enzogrando/GloveBot/docs/GloveBot_URD_.docx

PROJETO: GloveBot

Documento de Requisitos de Usuário (URD)

Luva de Controle de Garra Robótica via Bluetooth

Versão | V.2.0.0 | Data | 05/2026
Disciplina | Microcontroladores e Sistemas Embarcados | Prof. | Sérgio
Equipe | Enzo Medeiros Grando, Pedro Kuba Bloise, Gustavo Henrique Lamberti Widosnck, Gabriel Coutinho, João Victor Pessoa de Lima dos Anjos

# 1. Conceito e Descrição do Projeto

O GloveBot é um sistema embarcado de teleoperação robótica vestível que permite ao usuário controlar uma garra mecânica por meio de gestos naturais da mão. O sistema é composto por dois módulos: um emissor integrado a uma luva (wearable) e um receptor acoplado à garra robótica.

O módulo emissor, baseado na placa LilyPad IOT ATMega32U4, utiliza o acelerômetro MPU-6050 para capturar a inclinação e os movimentos do pulso do usuário, transmitindo esses dados sem fio via Bluetooth (HC-08 em modo Master) ao módulo receptor. O receptor, controlado pelo mbed LPC1768 (Cortex-M3), interpreta os dados recebidos via HC-08 em modo Slave e aciona o servo motor MG995 para abrir ou fechar a garra metálica de forma proporcional ao gesto detectado. O status da operação, incluindo o ângulo atual e a situação da garra (FECHADO, MEIO ou ABERTO), é exibido em tempo real em um display OLED 128x32 via I2C.

O projeto tem aplicação em robótica industrial e teleoperada, sendo especialmente relevante em cenários onde o operador humano precisa manipular objetos à distância — como em ambientes insalubres, perigosos ou de difícil acesso físico. Toda a solução é construída com módulos comerciais de baixo custo e fácil reposição, com o código-fonte, esquemático e documentação disponibilizados em repositório público no GitHub.

# 2. Diagrama de Blocos do Sistema

O sistema é composto por dois subsistemas que se comunicam via Bluetooth BLE — o emissor (luva) e o receptor (garra):

MÓDULO EMISSOR — LUVA

Acelerômetro (MPU-6050) | Microcontrolador (LilyPad ATMega32U4) | Bluetooth Master (HC-08)
Bateria Li-Ion Wearable | | Luva de Neoprene

↓ Bluetooth 4.0 BLE ↓

MÓDULO RECEPTOR — GARRA

Bluetooth Slave (HC-08) | Microcontrolador (mbed LPC1768) | Servo Motor (MG995)
Display OLED 128x32 | | Fonte 5V - 2A Externa

O MPU-6050 envia dados de aceleração ao LilyPad via I2C. O LilyPad calcula o pitch (ângulo de inclinação) e mapeia em um ângulo de 0° a 180°, transmitindo via Bluetooth para o mbed. O mbed converte o valor em sinal PWM para o servo MG995 e atualiza o display OLED em tempo real.

# 3. Componentes do Sistema

Módulo | Componente | Função
Luva (Emissor) | LilyPad IOT ATMega32U4 | Microcontrolador principal vestível
Luva (Emissor) | Acelerômetro MPU-6050 | Captura de movimento e inclinação do pulso (I2C)
Luva (Emissor) | Módulo Bluetooth HC-08 (Master) | Transmissão sem fio dos dados de gesto
Luva (Emissor) | Bateria Li-Ion Wearable | Alimentação independente sem cabos
Garra (Receptor) | mbed LPC1768 (Cortex-M3) | Processamento e controle do receptor
Garra (Receptor) | Módulo Bluetooth HC-08 (Slave) | Recepção dos dados via Bluetooth
Garra (Receptor) | Servo Motor MG995 | Atuação mecânica (abertura/fechamento da garra)
Garra (Receptor) | Display OLED 128x32 I2C | Exibição de status, ângulo e situação operacional
Garra (Receptor) | Fonte 5V - 2A | Alimentação do servo motor
Garra (Receptor) | Garra Metálica MG995 | Estrutura mecânica de pinça
Conexão/Suporte | Mini Protoboard 170 pinos | Montagem na luva
Conexão/Suporte | Jumpers M×M e M×F | Conexões entre módulos e placas
Conexão/Suporte | Velcro Adesivo | Fixação dos componentes na luva
Conexão/Suporte | Luva de Neoprene | Estrutura vestível do emissor

# 4. Protocolo de Comunicação

A comunicação entre os módulos utiliza Bluetooth 4.0 BLE através dos módulos HC-08. O pareamento é automático: o HC-08 da luva é configurado como Master (AT+ROLE=M) com conexão automática habilitada (AT+CONT=1), enquanto o HC-08 da garra mantém-se como Slave (padrão de fábrica).

O protocolo de mensagens é simples e direto:

A<angulo>\n

Exemplos: 'A0\n' (garra fechada), 'A90\n' (posição central), 'A180\n' (garra aberta). O caractere 'A' identifica o início do pacote e o '\n' indica o fim, garantindo robustez na decodificação mesmo com possível ruído na inicialização do Bluetooth.

# 5. Requisitos de Usuário

ID | Requisito | Tipo
UR-01 | Ser composto por módulos eletrônicos prontos e de fácil acesso comercial | Obrigatório
UR-02 | Capturar os movimentos e a inclinação do pulso do usuário por meio de acelerômetro | Obrigatório
UR-03 | Transmitir os dados de gesto de forma sem fio via Bluetooth para o módulo receptor | Obrigatório
UR-04 | Controlar a abertura e o fechamento de uma garra robótica por meio de servo motor | Obrigatório
UR-05 | O módulo emissor (luva) deve operar sem cabos, alimentado por bateria wearable | Obrigatório
UR-06 | O módulo receptor (garra) deve exibir o status da conexão e o ângulo de abertura em display OLED | Obrigatório
UR-07 | A resposta do sistema (gesto → movimento da garra) deve ocorrer em tempo real, com latência perceptível mínima | Obrigatório
UR-08 | O sistema deve tolerar variações de orientação da luva sem perda de controle | Obrigatório
UR-09 | Pareamento Bluetooth automático entre os módulos ao serem ligados | Obrigatório
UR-10 | Exibir status textual da garra no display (ABERTO / MEIO / FECHADO) | Desejável
UR-11 | Permitir calibração do ângulo de abertura via gesto específico | Desejável
UR-12 | Disponibilizar o código-fonte e esquemático elétrico em repositório público no GitHub | Desejável

Obrigatório — funcionalidade essencial para o sistema operar | Desejável — agrega valor mas não é crítico para a entrega

# 6. Repositório do Projeto

O código-fonte completo, documentação, esquemático e todos os arquivos do projeto estão disponíveis publicamente no GitHub:

https://github.com/enzogrando/GloveBot
