enzogrando/GloveBot/docs/WhatsApp Image 2026-06-03 at 18.21.32 (1).jpeg

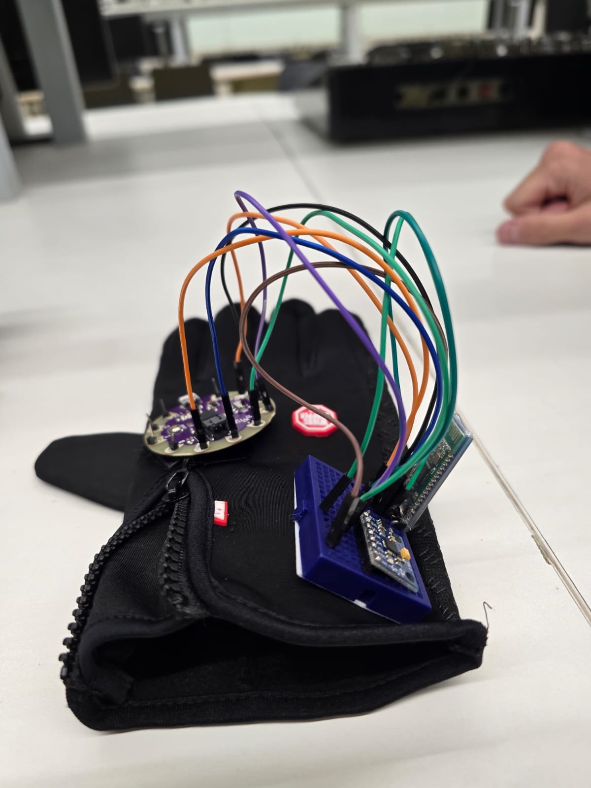
docs/WhatsApp Image 2026-06-03 at 18.21.32 (1).jpeg
