enzogrando/GloveBot/docs/WhatsApp Image 2026-06-03 at 18.21.36.jpeg

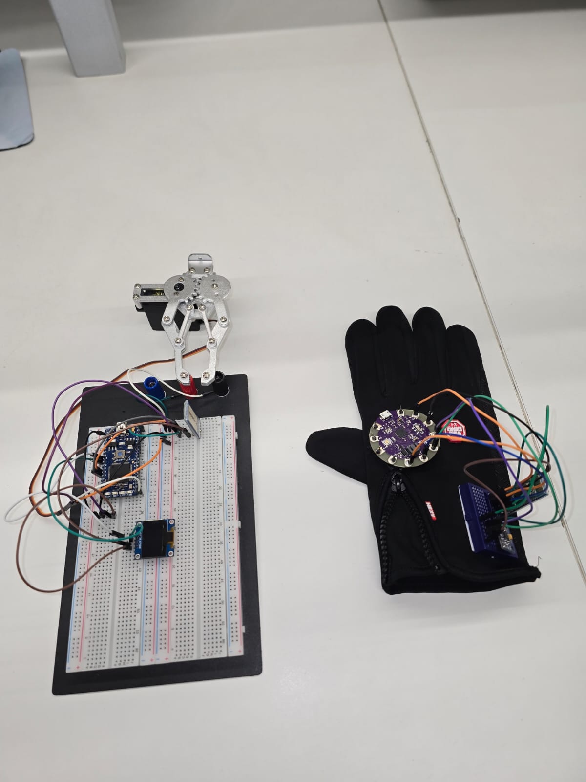
docs/WhatsApp Image 2026-06-03 at 18.21.36.jpeg
