enzogrando/GloveBot/(commit log)

2026-05-27 docs: atualiza URD com diagrama de blocos no estilo padrao
2026-09-30 feat: adiciona camada Raspberry Pi e dashboard Ubidots
2026-09-30 Add Raspberry Pi monitoring and dashboard instructions
    Added monitoring section with Raspberry Pi and dashboard details, including variables sent to the dashboard and instructions for running the script.
2026-10-21 feat: integra Raspberry Pi ao hardware real e atualiza URD
    - receptor: angulo pela Serial USB, OLED opcional, servo em microssegundos,
    sentido invertido, curso limitado e velocidade maxima
    - receptor: arquivos de build (mbed-tools) e .bin pronto
    - emissor: roll com filtro contra tremor, zona morta e faixa mais larga
    - emissor: sketch para configurar o HC-08 por comandos AT
    - raspberry: MODO_TESTE = False por padrao
    - README: compilacao sem Keil Studio, pareamento (AT+CONT=0), ajustes
    - URD v3.0.0 com a camada de monitoramento (Raspberry Pi + Ubidots)
    Claude-Session: https://claude.ai/code/session_01V2Fn3wbky1fLCtPYSUmk3G
2026-10-21 docs: remove bateria e display OLED, atualiza diagrama de blocos
    - diagrama de blocos com alimentacao da luva pela USB do PC e o
    modulo de monitoramento (Raspberry Pi + Ubidots); sem bateria e sem OLED
    - receptor: codigo do display OLED removido e .bin recompilado
    - README: componentes e pinagem sem bateria e sem OLED
    - URD v3.1.0: textos, tabelas e requisitos UR-05/06/10 atualizados,
    diagrama de blocos incluido como figura
    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
2026-10-21 docs: substitui as fotos do projeto pelas da montagem atual
    Fotos da luva com a garra, do receptor na protoboard, do Raspberry Pi
    e do sistema completo; galeria do README atualizada.
    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
2026-10-21 docs: substitui o video de demonstracao
    Novo video mostra a luva controlando a garra e o dashboard do Ubidots
    atualizando em tempo real.
    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
2026-10-21 docs: GIF animado da demonstracao no README
    O GitHub nao reproduz .mp4 do repositorio dentro do README; o GIF
    anima direto na pagina e o MP4 continua disponivel para download.
    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
2026-10-21 docs: separa as entregas T1, T2 e T3 no README
    Tabela de entregas no topo e secoes proprias para o Raspberry Pi (T2)
    e para o dashboard Ubidots (T3).
    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
